nppc/AutoWatering/Images/PCB.png

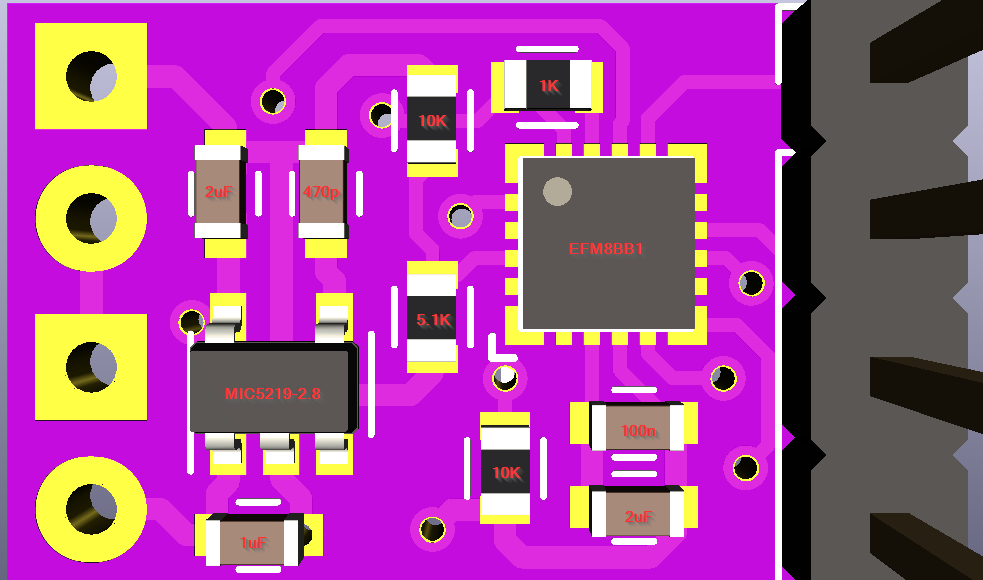
Images/PCB.png
