nppc/AutoWatering/(list of files, cad)

Other CAD files:
Firmware/AutoWaterLight/Keil 8051 v9.60.0 - Debug/src/main.OBJ
Firmware/AutoWater/Keil 8051 v9.60.0 - Debug/src/main.OBJ
Firmware/AutoWater/Keil 8051 v9.60.0 - Debug/src/screensaver.OBJ
Firmware/AutoWaterLight/Keil 8051 v9.60.0 - Debug/src/Interrupts.OBJ
Firmware/AutoWater/Keil 8051 v9.60.0 - Debug/src/SSD1306.OBJ
Firmware/AutoWaterLight/Keil 8051 v9.60.0 - Debug/src/SSD1306.OBJ
Firmware/AutoWater/Keil 8051 v9.60.0 - Debug/src/SILABS_STARTUP.OBJ
Firmware/AutoWaterLight/Keil 8051 v9.60.0 - Debug/src/button.OBJ
Firmware/AutoWater/Keil 8051 v9.60.0 - Debug/src/gen.OBJ
Firmware/AutoWaterLight/Keil 8051 v9.60.0 - Debug/src/i2c.OBJ
Firmware/AutoWater/Keil 8051 v9.60.0 - Debug/src/pgm.OBJ
Firmware/AutoWater/Keil 8051 v9.60.0 - Debug/src/button.OBJ
Firmware/AutoWaterLight/Keil 8051 v9.60.0 - Debug/src/InitDevice.OBJ
Firmware/AutoWater/Keil 8051 v9.60.0 - Debug/src/i2c.OBJ
Firmware/AutoWaterLight/Keil 8051 v9.60.0 - Debug/src/screensaver.OBJ
Firmware/AutoWater/Keil 8051 v9.60.0 - Debug/src/Interrupts.OBJ
Firmware/AutoWaterLight/Keil 8051 v9.60.0 - Debug/src/pgm.OBJ
Firmware/AutoWaterLight/Keil 8051 v9.60.0 - Debug/src/pwm.OBJ
Firmware/AutoWater/Keil 8051 v9.60.0 - Debug/src/InitDevice.OBJ
Firmware/AutoWaterLight/Keil 8051 v9.60.0 - Debug/src/SILABS_STARTUP.OBJ
Firmware/AutoWaterLight/Keil 8051 v9.60.0 - Debug/src/gen.OBJ
