nppc/AutoWatering/KiCad/AutoWaterLight/AutoWaterLight.kicad_pcb

## KiCad design KiCad/AutoWaterLight/AutoWaterLight.kicad_pcb (2021-08-28)

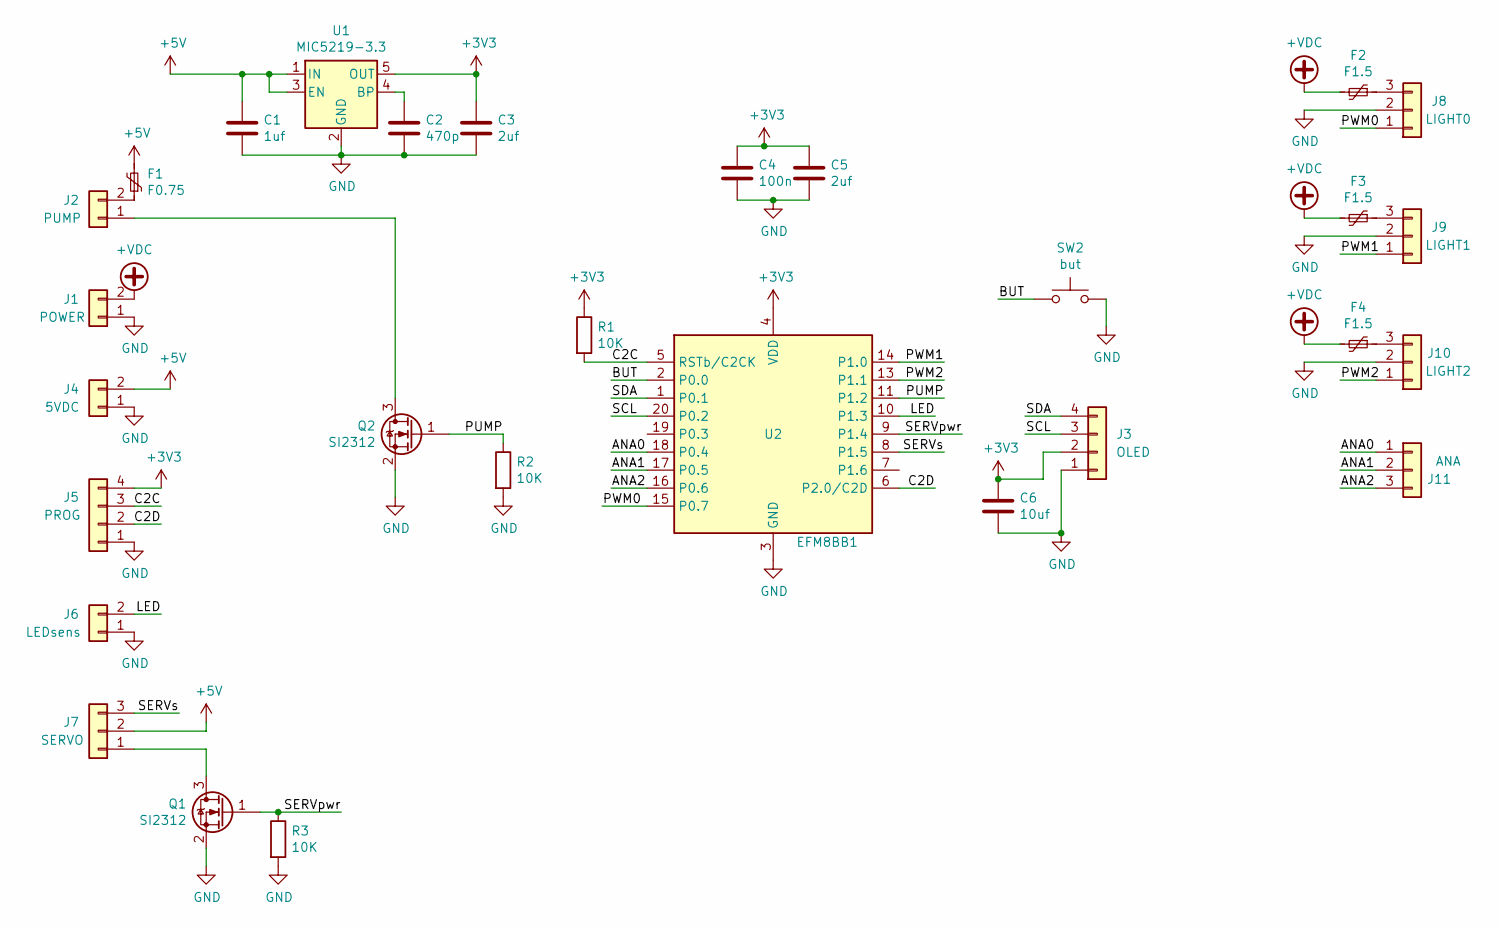
[picture p4: schematic AutoWaterLight.sch]

Parts:
C1: 1uf; C_0603
C2: 470p; C_0603
C3, C5: 2uf; C_0603
C4: 100n; C_0603
C6: 10uf; C_0603
F1: F0.75; R_1812
F2, F3, F4: F1.5; R_1812
J1: POWER; Conn_Power
J2: PUMP; Conn_1x02_2.54_0.9mm
J3: OLED; Pin_Header_Straight_1x04_Pitch2.54mm
J4: 5VDC; Conn_1x02_2.54_0.9mm
J5: PROG; Molex_PicoBlade_53047-0410_04x1.25mm_Straight
J6: LEDsens; Conn_1x02_2.54_0.9mm
J7: SERVO; Conn_1x03_2.54mm
J8: LIGHT0; Conn_1x03_2.54mm
J9: LIGHT1; Conn_1x03_2.54mm
J10: LIGHT2; Conn_1x03_2.54mm
J11: ANA; PROG-3pin
Q1, Q2: SI2312; SOT-23
R1, R2, R3: 10K; R_0603
SW2: but; POWER2PIN_2
U1: MIC5219-3.3; SOT-23-5
U2: EFM8BB1; QFN20

Connections:
+3V3: C3.1, C4.1, C5.1, C6.1, J3.2, J5.4, R1.1, U1.5 (OUT), U2.4 (VDD)
+5V: C1.1, F1.2, J4.2, J7.2, U1.1 (IN), U1.3 (EN)
+VDC: F2.2, F3.2, F4.2, J1.2
/ANA0: J11.1, U2.18 (P0.4)
/ANA1: J11.2, U2.17 (P0.5)
/ANA2: J11.3, U2.16 (P0.6)
/BUT: SW2.1, U2.2 (P0.0)
/C2C: J5.3, R1.2, U2.5 (RSTb/C2CK)
/C2D: J5.2, U2.6 (P2.0/C2D)
/LED: J6.2, U2.10 (P1.3)
/PUMP: Q2.1 (G), R2.1, U2.11 (P1.2)
/PWM0: J8.1, U2.15 (P0.7)
/PWM1: J9.1, U2.14 (P1.0)
/PWM2: J10.1, U2.13 (P1.1)
/SCL: J3.3, U2.20 (P0.2)
/SDA: J3.4, U2.1 (P0.1)
/SERVpwr: Q1.1 (G), R3.1, U2.9 (P1.4)
/SERVs: J7.3, U2.8 (P1.5)
GND: C1.2, C2.2, C3.2, C4.2, C5.2, C6.2, J1.1, J3.1, J4.1, J5.1, J6.1, J8.2, J9.2, J10.2, Q1.2 (S), Q2.2 (S), R2.2, R3.2, SW2.2, U1.2 (GND), U2.3 (GND), U2.12 (GND), U2.21 (GND)
unnamed: C2.1, U1.4 (BP)
unnamed: F1.1, J2.2
unnamed: F2.1, J8.3
unnamed: F3.1, J9.3
unnamed: F4.1, J10.3
unnamed: J2.1, Q2.3 (D)
unnamed: J7.1, Q1.3 (D)

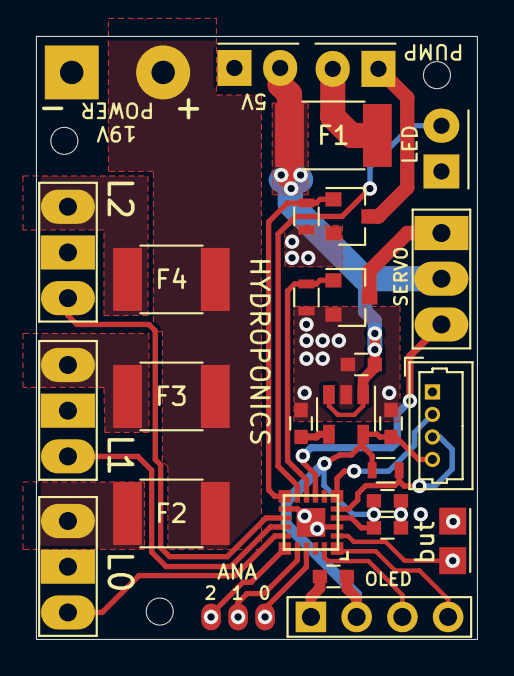
[picture p5: board AutoWaterLight.kicad_pcb from above]

Board: 2 copper layers, 24.5 x 33.5 mm, 29 parts (0 on the bottom side), 26 nets.
