nppc/AutoWatering/KiCad/AutoWater/AutoWater.kicad_pcb

## KiCad design KiCad/AutoWater/AutoWater.kicad_pcb (2021-07-16)

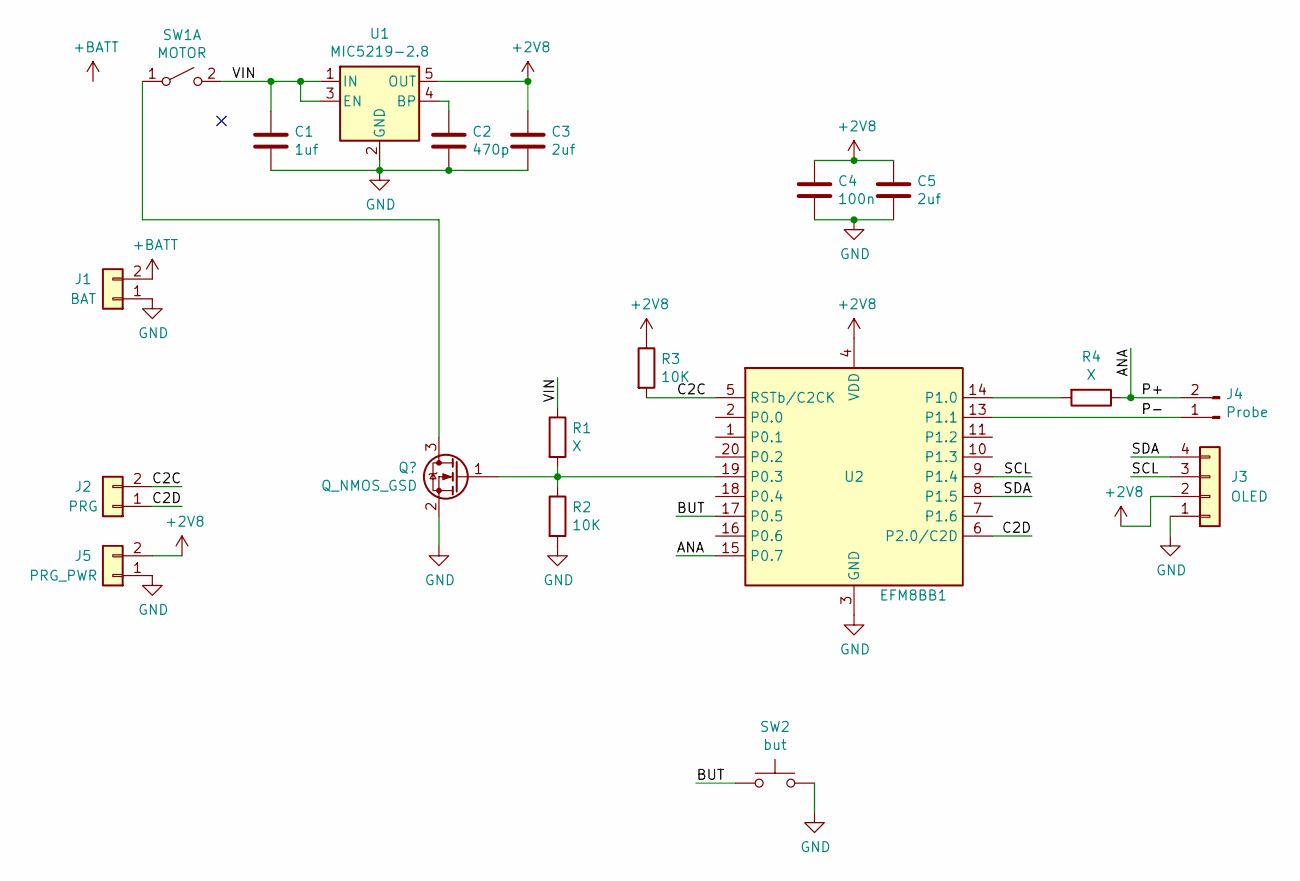
[picture p6: schematic AutoWater.sch]

Parts:
C1: 1uf; C_0603
C2: 470p; C_0603
C3, C5: 2uf; C_0603
C4: 100n; C_0603
J1: BAT; Conn_1x02_2.54_0.9mm
J2: PRG; POWER2PIN_2
J3: OLED; Pin_Header_Straight_1x04_Pitch2.54mm
J4: Probe; POWER2PIN_2
J5: PRG_PWR; POWER2PIN_2
R1, R4: X; R_0603
R2, R3: 10K; R_0603
SW1: MOTOR; Conn_1x02_2.54_0.9mm
SW2: but; POWER2PIN_2
U1: MIC5219-2.8; SOT-23-5
U2: EFM8BB1; QFN20

Connections:
+2V8: C3.1, C4.1, C5.1, J3.2, J5.2, R3.1, U1.5 (OUT), U2.4 (VDD)
+BATT: J1.2, SW1.1 (A)
/ANA: J4.2, R4.1, U2.15 (P0.7)
/BUT: SW2.1, U2.17 (P0.5)
/C2C: J2.2, R3.2, U2.5 (RSTb/C2CK)
/C2D: J2.1, U2.6 (P2.0/C2D)
/P-: J4.1, U2.13 (P1.1)
/SCL: J3.3, U2.9 (P1.4)
/SDA: J3.4, U2.8 (P1.5)
/VIN: C1.1, R1.1, SW1.2 (B), U1.1 (IN), U1.3 (EN)
GND: C1.2, C2.2, C3.2, C4.2, C5.2, J1.1, J3.1, J5.1, R2.2, SW2.2, U1.2 (GND), U2.3 (GND), U2.12 (GND), U2.21 (GND)
unnamed: C2.1, U1.4 (BP)
unnamed: R1.2, R2.1, U2.19 (P0.3)
unnamed: R4.2, U2.14 (P1.0)

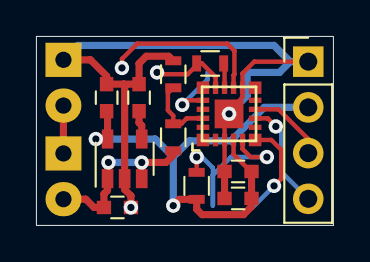
[picture p7: board AutoWater.kicad_pcb from above]

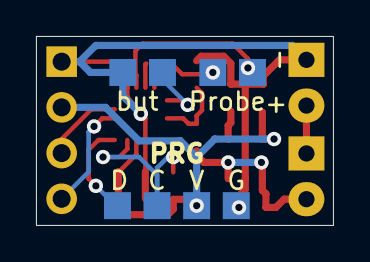
[picture p8: board AutoWater.kicad_pcb from below]

Board: 2 copper layers, 16.5 x 10.5 mm, 18 parts (4 on the bottom side), 14 nets.
