nppc/AutoWatering/Firmware/AutoWateringLight21/src/bitmaps.c

#include "bitmaps.h"

const uint8_t code num_font_bitmap[] = {
// 'Font0v2', 9x16px
0xe0, 0xf8, 0x18, 0x04, 0x04, 0x04, 0x1c, 0xf8, 0xe0, 0x0f, 0x3f, 0x70, 0x40, 0x40, 0x40, 0x30,
0x3f, 0x0f,
// 'Font1v2', 9x16px
0x00, 0x30, 0x10, 0x18, 0xfc, 0xfc, 0x00, 0x00, 0x00, 0x00, 0x00, 0x00, 0x00, 0x7f, 0x7f, 0x00,
0x00, 0x00,
// 'Font2v2', 9x16px
0x18, 0x08, 0x04, 0x04, 0x04, 0x8c, 0xf8, 0xf0, 0x00, 0x70, 0x78, 0x4c, 0x46, 0x46, 0x43, 0x41,
0x40, 0x40,
// 'Font3v2', 9x16px
0x00, 0x00, 0x04, 0x04, 0x04, 0x04, 0x8c, 0xf8, 0x70, 0x00, 0x60, 0x41, 0x41, 0x41, 0x41, 0x62,
0x3e, 0x1c,
// 'Font4v2', 9x16px
0x00, 0x00, 0x00, 0x80, 0x60, 0x38, 0xfc, 0xfc, 0x00, 0x0c, 0x0e, 0x0b, 0x09, 0x08, 0x08, 0x7f,
0x7f, 0x08,
// 'Font5v2', 9x16px
0x00, 0xfc, 0xfc, 0x84, 0x84, 0x84, 0x04, 0x00, 0x00, 0x00, 0x60, 0x40, 0x40, 0x40, 0x61, 0x3f,
0x1e, 0x00,
// 'Font6v2', 9x16px
0xc0, 0xf0, 0x38, 0x8c, 0x84, 0x84, 0x84, 0x04, 0x00, 0x0f, 0x3f, 0x61, 0x40, 0x40, 0x40, 0x61,
0x3f, 0x1e,
// 'Font7v2', 9x16px
0x00, 0x04, 0x04, 0x04, 0x04, 0x84, 0xe4, 0x3c, 0x0c, 0x00, 0x00, 0x00, 0x60, 0x7e, 0x0f, 0x01,
0x00, 0x00,
// 'Font8v2', 9x16px
0x00, 0x70, 0xf8, 0x8c, 0x04, 0x8c, 0xf8, 0x70, 0x00, 0x1c, 0x3e, 0x62, 0x41, 0x41, 0x41, 0x62,
0x3e, 0x1c,
// 'Font9v2', 9x16px
0xf0, 0xf8, 0x0c, 0x04, 0x04, 0x04, 0x0c, 0xf8, 0xe0, 0x00, 0x41, 0x43, 0x42, 0x42, 0x62, 0x31,
0x1f, 0x07,
// 'FontMinusv2', 9x16px
0x00, 0x00, 0x00, 0x00, 0x00, 0x00, 0x00, 0x00, 0x00, 0x00, 0x00, 0x02, 0x02, 0x02, 0x02, 0x02,
0x00, 0x00,
};

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
0x08, 0x08, 0x08, 0x08, 0x04, 0x03},
{// 'Sun', 19x16px
0x00, 0x00, 0x80, 0x82, 0x84, 0x08, 0xc0, 0x20, 0x10, 0x17, 0x10, 0x20, 0xc0, 0x08, 0x84, 0x82,
0x80, 0x00, 0x00, 0x00, 0x00, 0x00, 0x20, 0x10, 0x08, 0x01, 0x02, 0x04, 0x74, 0x04, 0x02, 0x01,
0x08, 0x10, 0x20, 0x00, 0x00, 0x00}
};
