nppc/AutoWatering/Firmware/AutoWateringLight21/src/bitmaps.h

#ifndef BITMAPS_H_
#define BITMAPS_H_

#include "main.h"

// https://diyusthad.com/image2cpp

extern const uint8_t code num_font_bitmap[];

extern const uint8_t code dot_bitmap[];

extern const uint8_t code font6x8[];

extern const uint8_t code time_h_bitmap[];

extern const uint8_t code time_m_bitmap[];

extern const uint8_t code time_s_bitmap[];

extern const uint8_t code hold_bitmap[];

extern const uint8_t code hourglass_bitmap[];

extern const uint8_t code waterrunning_bitmap[];

extern const uint8_t code clock_bitmap[];

extern const uint8_t code dayphase_bitmap[][38];

extern const uint8_t code lightOn_bitmap[];

extern const uint8_t code lightOff_bitmap[];

extern const uint8_t code water_bitmap[];

extern const uint8_t code dayphase_bitmap[][38];

#endif /* BITMAPS_H_ */
