nppc/AutoWatering/Firmware/AutoWateringLight21/src/screensaver.h

#ifndef SCREENSAVER_H_
#define SCREENSAVER_H_

#define SSAVERDELAY (60 * 3) // 3 minutes
#define SSAVERMAXDOTS 40 // maximum dots for a screensaver to show at the same time

typedef struct
{
  uint8_t x,y; // x,y - coordinate of a dot.
  uint16_t sramaddr; // samebyte - indicates that this coordinate will be on the same OLED SRAM address.
} ssaverdots_t;

extern ssaverdots_t xdata ssdots[];
extern bit ssaverstart, ssaverupdate;
void initSSaver(void);
void fillSSaverBuffer(void);
void drawSSaverOled(void);
void replaceSSaverStar(void);

#endif /* SCREENSAVER_H_ */
