nppc/AutoWatering/(commit log)

2021-07-16 Display timers
2021-07-16 timers working
2021-07-18 PCB bottom side
2021-07-20 Config short press done
    [main.c]
2021-07-21 Config button long press
2021-08-16 complete device photos
2021-08-28 Add auto watering light project
    [AutoWater.kicad_pcb, AutoWater.sch, AutoWaterLight.kicad_pcb, AutoWaterLight.sch, InitDevice.OBJ, Interrupts.OBJ, SILABS_STARTUP.OBJ, SSD1306.OBJ]
2021-10-09 Simplify pwm control
2021-10-22 light sensor
2021-10-25 fix issue with light if there is night outside
    [gen.c]
2021-10-25 fix issue with not updating the timer right away
    [gen.c, main.c]
2021-11-07 Combine all 3 pwm outs
2021-12-21 Add kalman filter
2021-12-21 Kalman is added to light sensor
2022-01-11 Move PWM routines from Interrupts to main loop
2022-01-24 turn on/off leds on button
